chrisburtner/rotibot/test_data/0/description.txt

****************************************************************
none
jnpitt@uw.edu
jason
none
1496168130
0
none
1
/var/www/robot_data/260/
0
0
expID:260
440
14012
3
A3
****************************************************************
::br::
