chrisburtner/rotibot/documentation/software/11.pdf

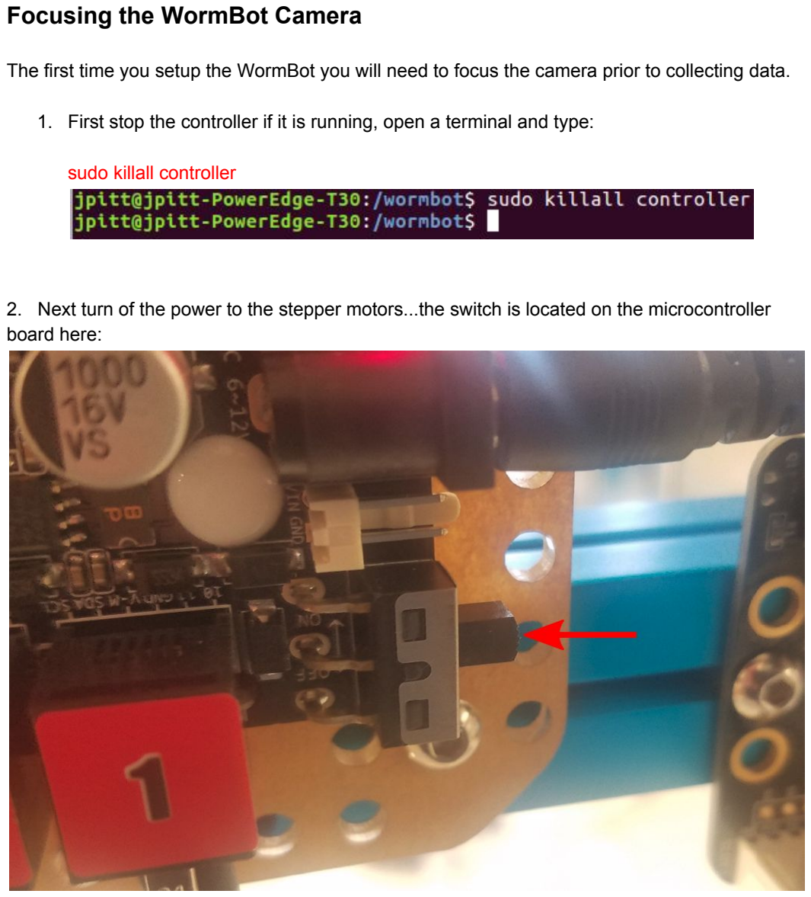
[picture p1: page 1]

### Focusing the WormBot Camera

The first time you setup the WormBot you will need to focus the camera prior to collecting data.

1. First stop the controller if it is running, open a terminal and type:

sudo killall controller

2. Next turn of the power to the stepper motors...the switch is located on the microcontroller board here:

3. Place a 12-well plate with some worms in a well on the robot and manually move the camera over the well. Note: This is discussed in other areas but the agar volume in the well should be 3mL. It is important to keep this volume fixed, although the camera has a decent depth of field and the worms will still be in focus even with some evaporation.

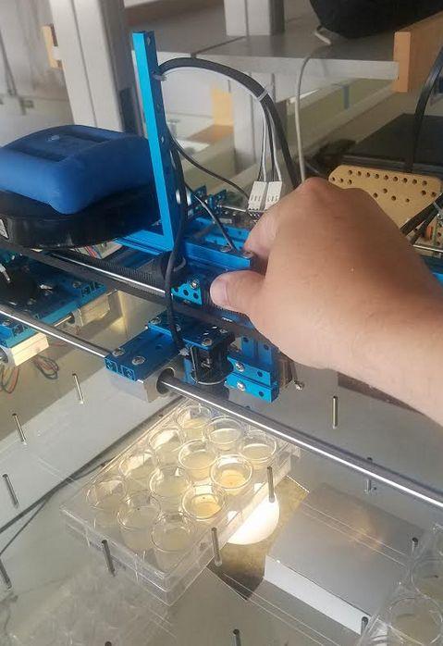
[picture p2: figure]
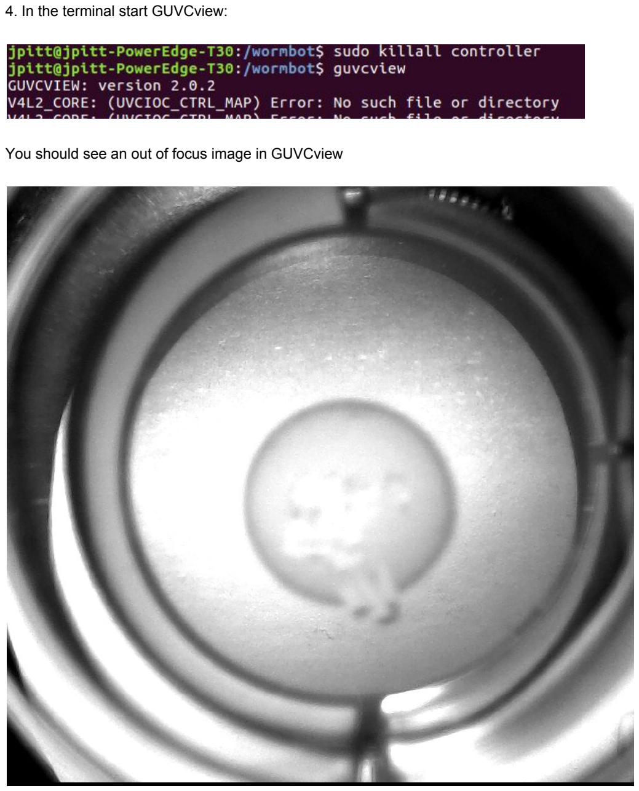
[picture p3: page 3]

4. In the terminal start GUVCview:

You should see an out of focus image in GUVCview

5. Center the camera head over the well and then rotate the camera lens to focus on the worms so that they are in sharp focus in the GUVCview window

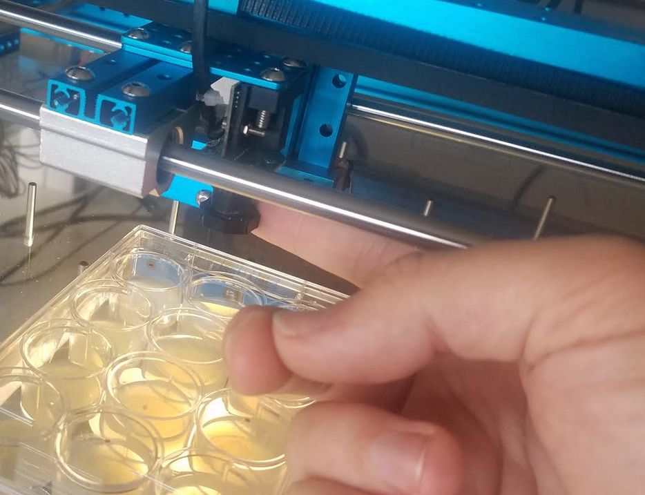
[picture p4: figure]

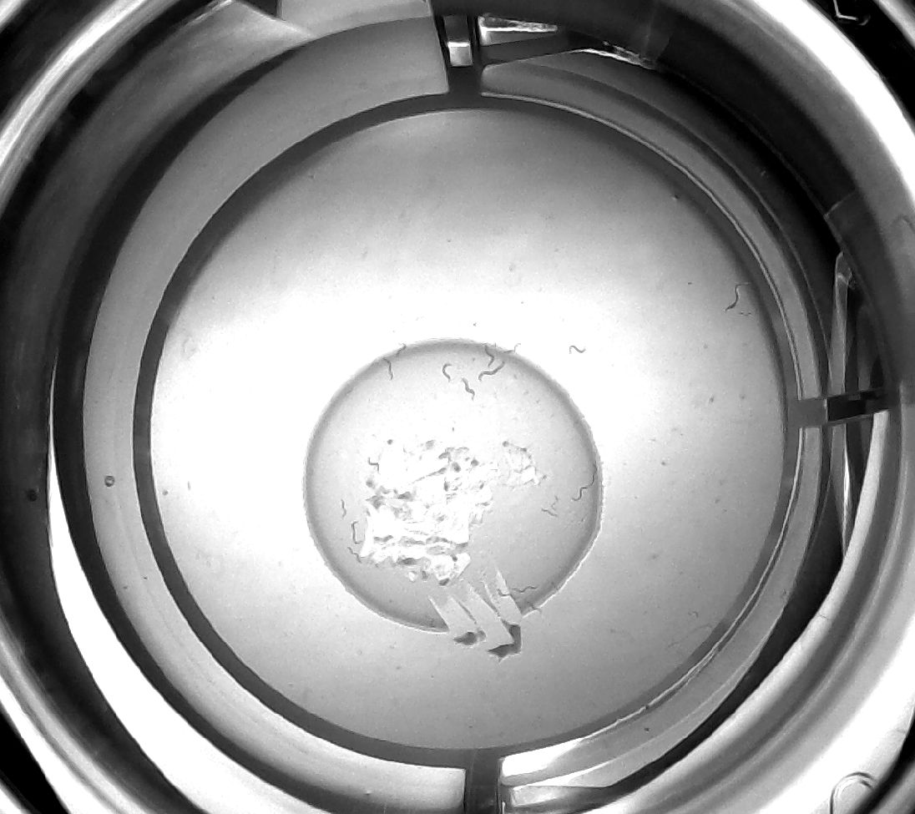
[picture p5: figure]

Note: this is also a good time to adjust your reflector angle to make sure you have optimal contrast and illumination. You can also adjust the brightness and contrast settings in
GUVCview until the image looks optimal and then update the values in /wormbot/camera.config

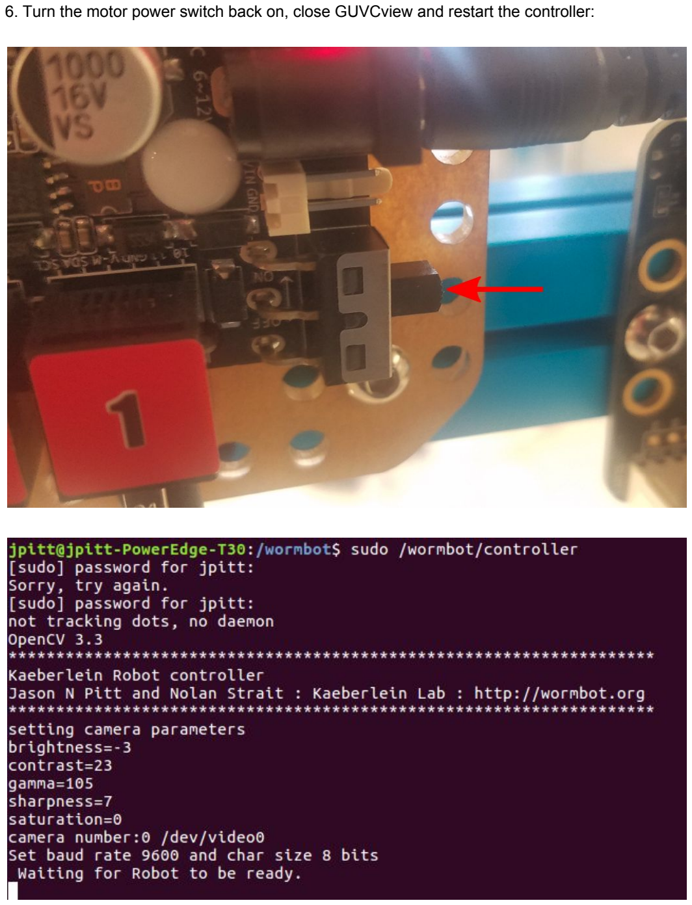
[picture p6: page 6]

6. Turn the motor power switch back on, close GUVCview and restart the controller:
