chrisburtner/rotibot/documentation/software/5.pdf

### Manually scoring a lifespan with the Marker application

The Marker application is an extremely lightweight cgi-app that allows you to score experiments in a web browser on any sort of device (tablet, smartphone, etc). However it is manual, so you will have to scroll through the movie and mark the death point of each worm. For a more automated approach we have a web app, Retrograde, that uses javascript and requires a three button mouse and will do much of the work for you. That said, some users still prefer the Marker application.

1. To open the Marker application, open a web browser on the server attached to the WormBot and go to: http://127.0.0.1/cgi-bin/experimentbrowser

Note: If you take sufficient security precautions you can assign you server a domain name and make it accessible from outside your local network, therby replacing the loop-back IP
(127.0.0.1) with your actual domain name or IP address
2. From the experiment browser scroll to the experiment of interest and click on the ExpID or on the title or description to open the Marker application.

Note: If you already know the experiment ID you can also manually enter the URL such as: http://127.0.0.1/cgi-bin/marker?loadedexpID=XXX where you would replace XXX with the experiment ID number

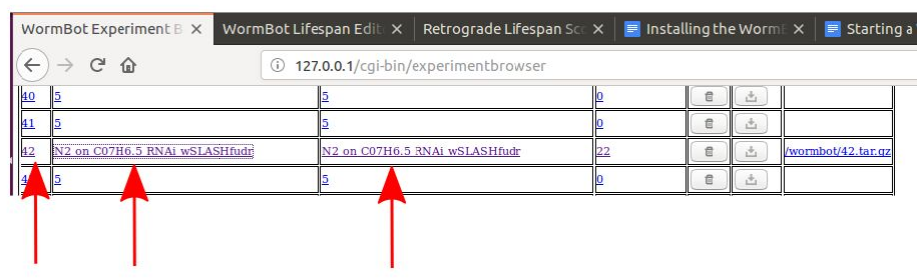
[picture p22: figure]

3. When you open the Marker application you will be presented with the following interface:

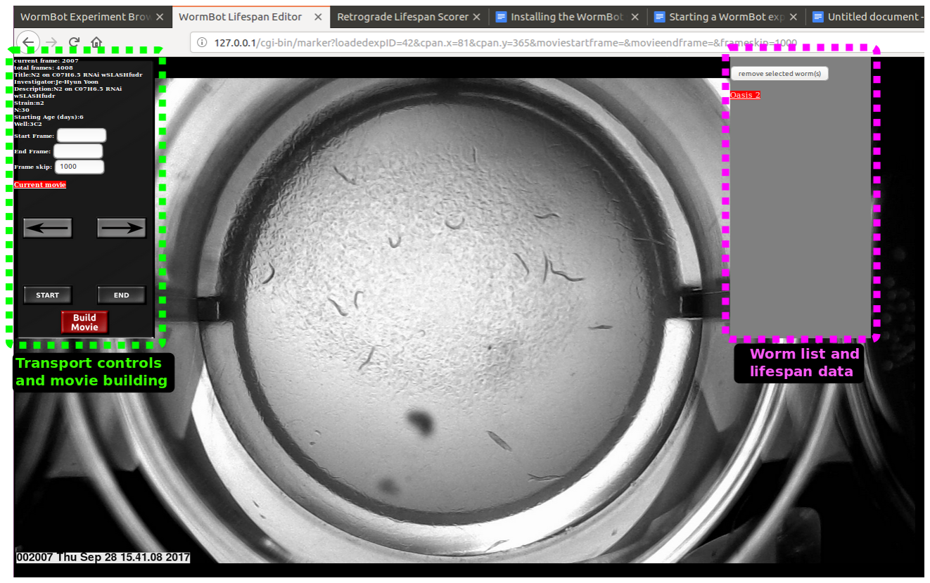
[picture p23: figure]

4. The left hand side (highlighted in green above) are the transport controls for scrolling through the experimental data. In the top portion of this control window are some details of the experiment, the currently displayed frame, the total number of frames, the title for the experiment and the description, the strain name, the starting age and well number. Below that are 3 input fields. The field labeled Frame skip, controls the number of frames the will be moved when you left click on either the left or right arrow buttons in the control window. Right is forward in time, left, backwards in time. The START and END buttons will transport you to the first and last frames of the data set respectively.

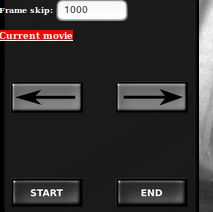
[picture p24: figure]

5. Manually scoring the data. Use the transport arrow buttons to move through the data set. When you observe a worm that ceases all body movement left click on the center of the worm. This will produce a numbered red circle on the worm and will add the worm to the wormlist window on the right side of the screen.

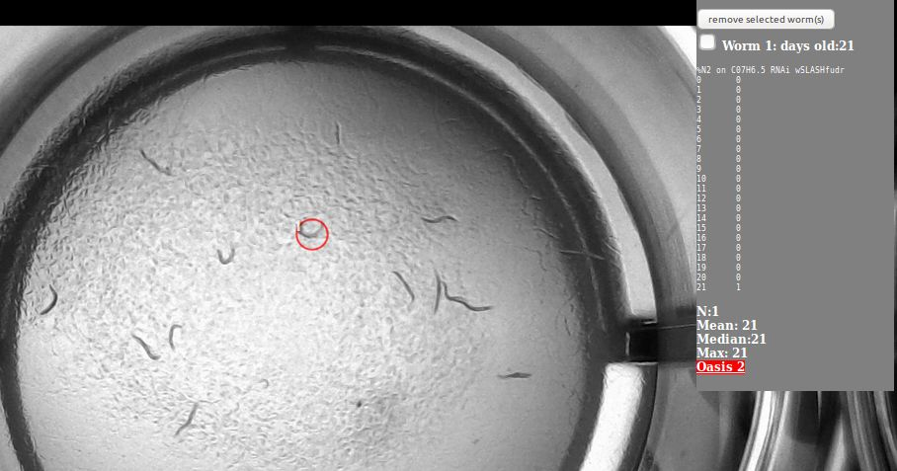
[picture p25: figure]

6. Continue processing the data until all worm death events have been marked. At this point the wormlist will have an observed N, mean, median and max lifespans. If you make a mistake or want to change the time/location of a worm’s death click in the checkbox next to the worm’s number in the wormlist window and click the remove selected worm button, then remark the death event at the desired timepoint.

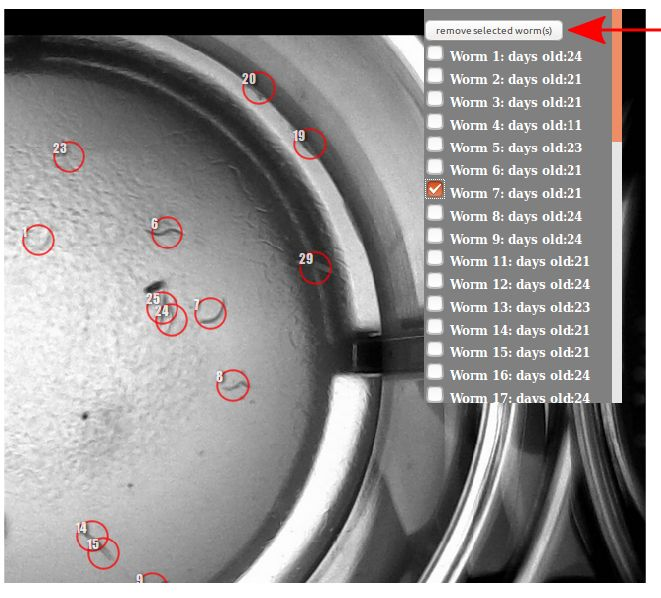
[picture p26: figure]

7. The bottom of the wormlist window contains the lifespan information in the format for the survival analysis web application OASIS 2 http://sbi.postech.ac.kr/oasis2/ You can copy the data from the wormlist window and click the OASIS 2 link in the bottom of the window and then use OASIS to analyze the data.

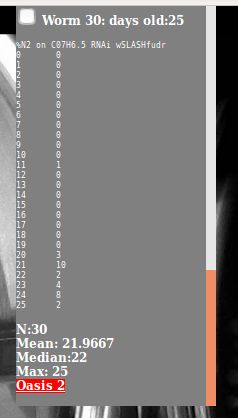
[picture p27: figure]

8. The other two fields in the left side Transport window, Start Frame and End Frame, control the Marker application’s movie making capability. To make a timelapse movie of the experiment, set the start frame and end frame fields to the desired start and end points and then left click on the red Build Movie button. Once the movie has been built you can download it by clicking on the Current Movie link. Note: for long movies this may take several minutes to complete. The movie will incorporate the marked death events in the final output.

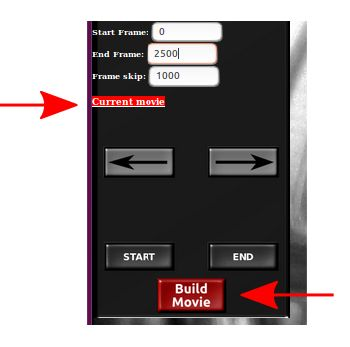
[picture p28: figure]
