chrisburtner/rotibot/documentation/software/8.pdf

### Manually starting the Controller and Alignerd applications

1. While the WormBot software has been observed to run problem free for months at a time occasionally things happen and the robot software may crash; either the aligner daemon (alignerd) or the WormBot controller itself. Symptoms that may indicate a crash are that the robot is no longer moving and collecting frames, indicating that controller has crashed or if aligned frames are no longer appearing indicating an alignerd crash.
2. To see if the software is running open a terminal window and type the command top (press the q key to exit top)

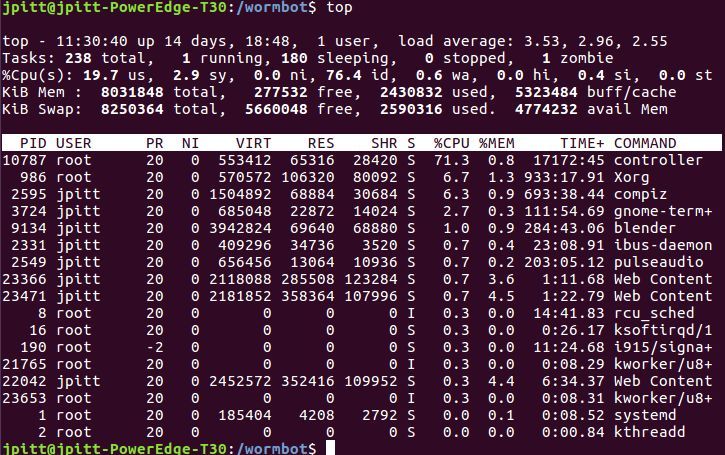
[picture p60: figure]

3. In the above example you can see that the top processes list does not contain the alignerd but does contain controller.

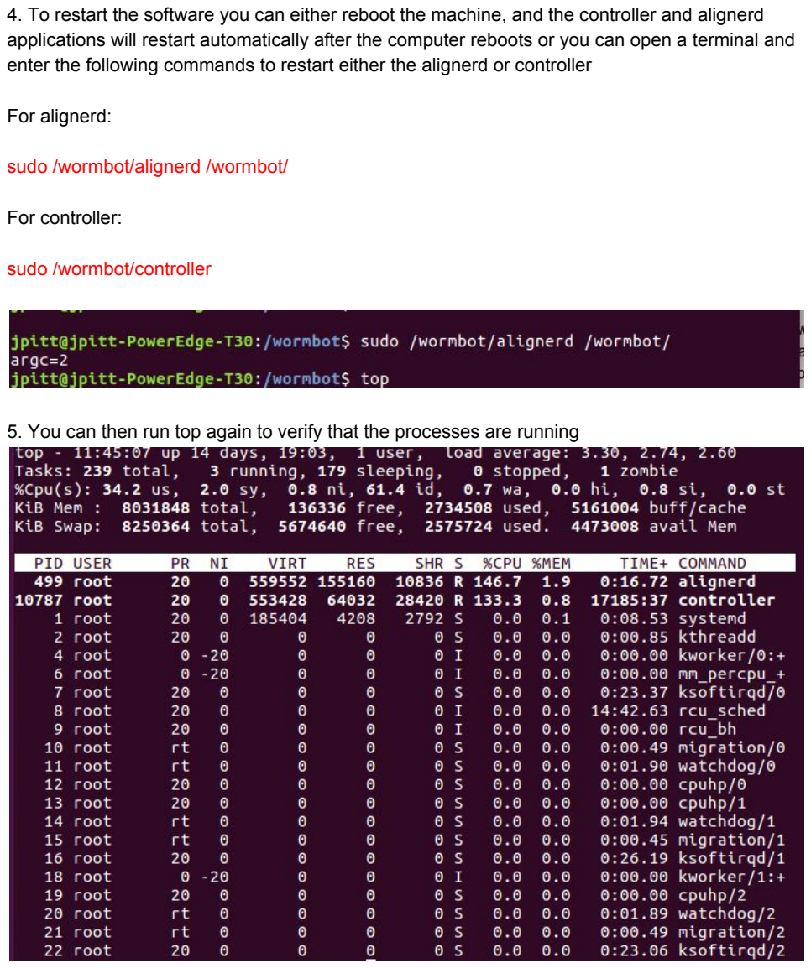
[picture p61: page 2]

4. To restart the software you can either reboot the machine, and the controller and alignerd applications will restart automatically after the computer reboots or you can open a terminal and enter the following commands to restart either the alignerd or controller

For alignerd:

sudo /wormbot/alignerd /wormbot/

For controller:

sudo /wormbot/controller

5. You can then run top again to verify that the processes are running
