chrisburtner/rotibot/stl_files/v3_standard/v3full_estop.stl

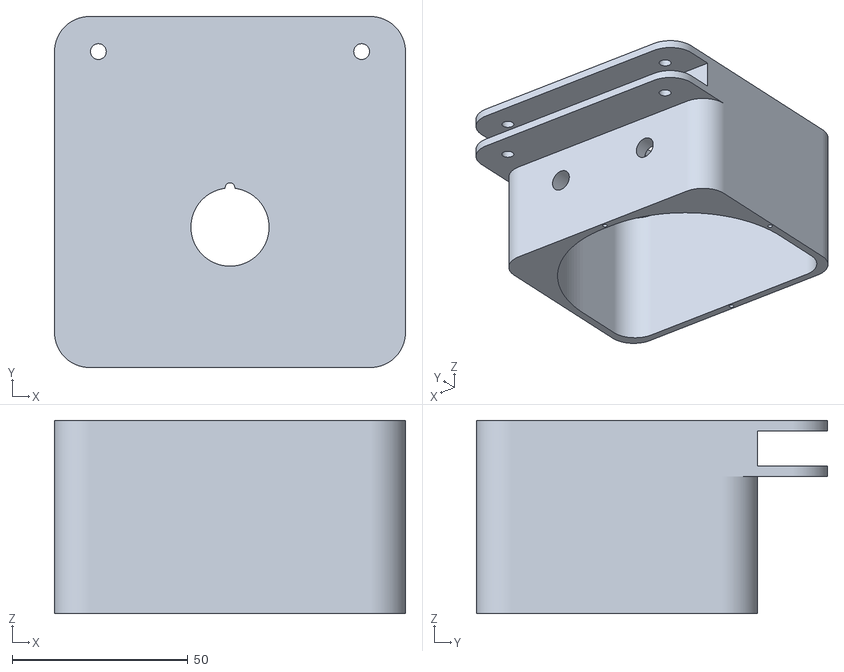
[picture p62: CAD file, 2022-04-04]
stl_files/v3_standard/v3full_estop.stl
100.0 x 100.0 x 55.0
