chrisburtner/rotibot/stl_files/common_parts/commonPartsPrintSet_3.stl

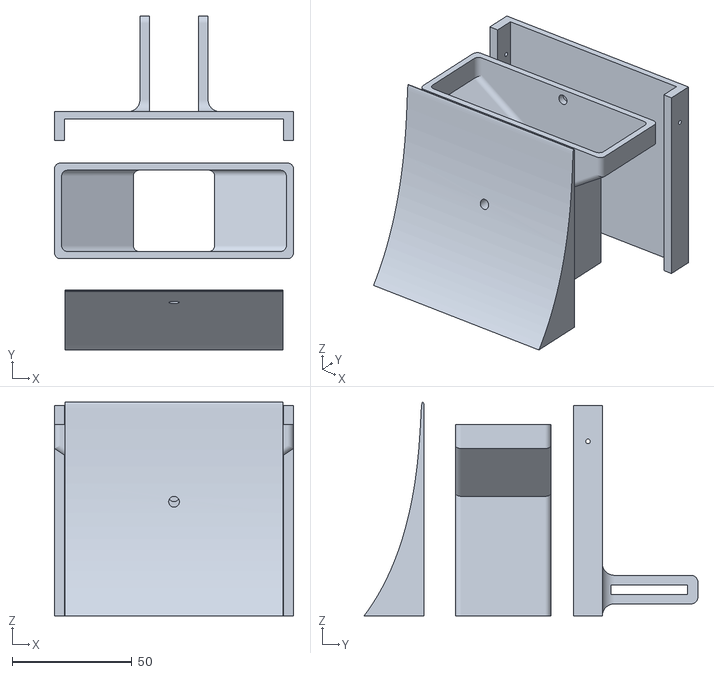
[picture p63: CAD file, 2022-10-11]
stl_files/common_parts/commonPartsPrintSet_3.stl
100.0 x 139.7 x 89.4
