chrisburtner/rotibot/stl_files/darkfield/highbase.stl

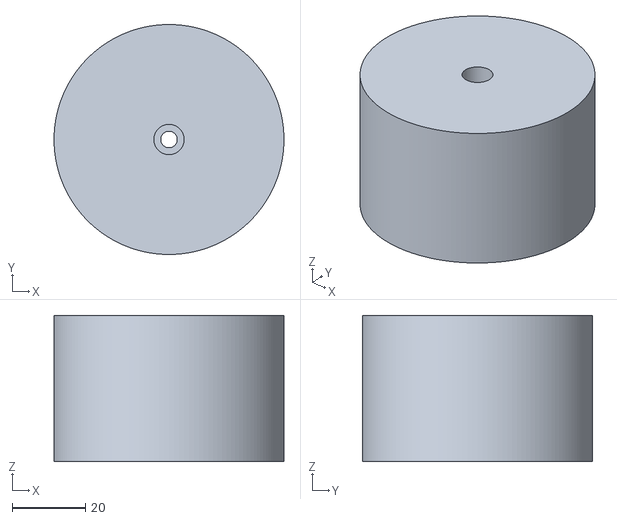
[picture p64: CAD file, 2022-02-23]
stl_files/darkfield/highbase.stl
62.8 x 62.8 x 40.0
