chrisburtner/rotibot/stl_files/v3_mini/miniPartsPrintSet.stl

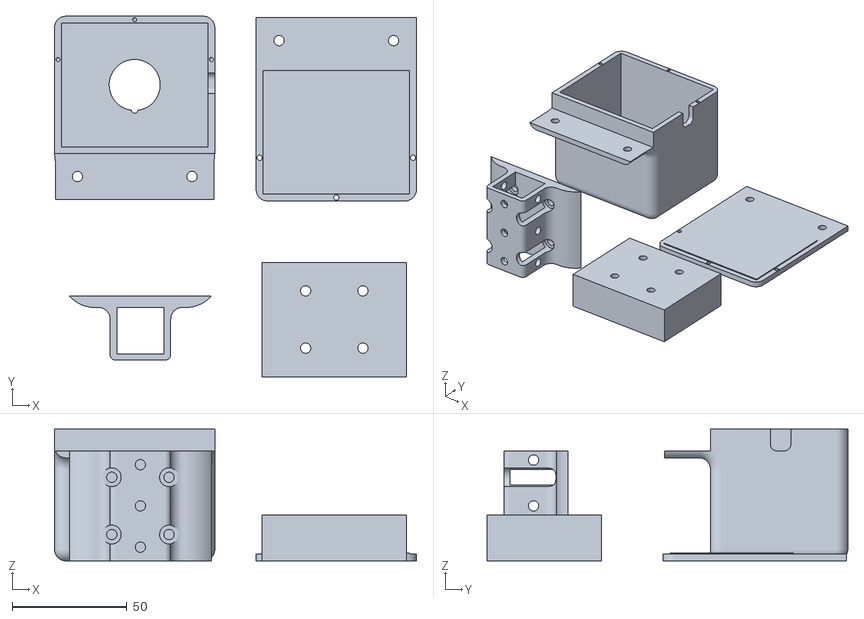
[picture p65: CAD file, 2022-10-10]
stl_files/v3_mini/miniPartsPrintSet.stl
158.0 x 157.4 x 57.5
