chrisburtner/rotibot/stl_files/v3_standard/standardPrintSet.stl

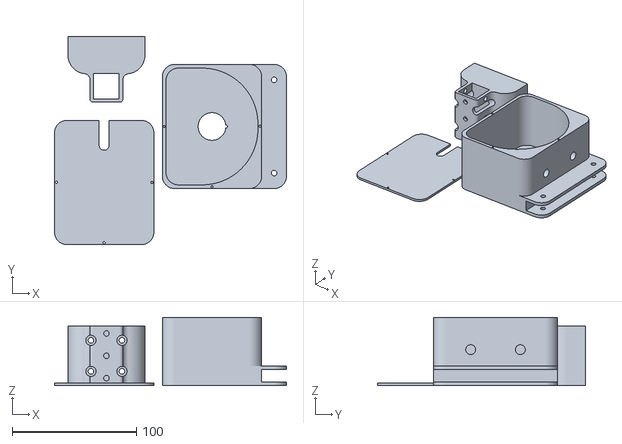
[picture p66: CAD file, 2022-10-10]
stl_files/v3_standard/standardPrintSet.stl
186.8 x 167.6 x 55.0
