chrisburtner/rotibot/stl_files/v3F/fluorescencePrintSet.stl

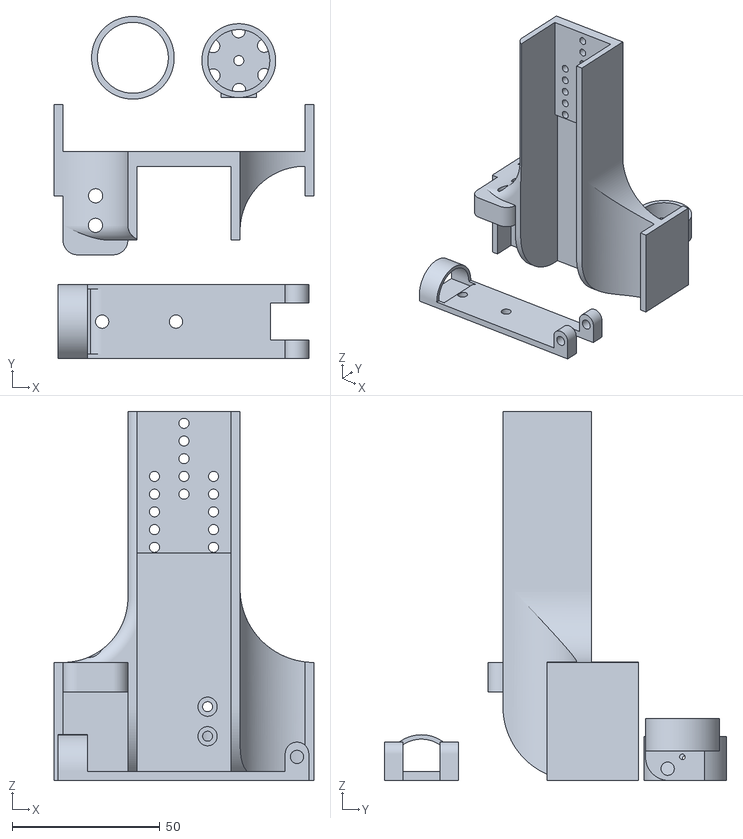
[picture p67: CAD file, 2022-10-07]
stl_files/v3F/fluorescencePrintSet.stl
88.0 x 115.9 x 125.0
