chrisburtner/rotibot/stl_files/common_parts/v3-reflector-tube.stl

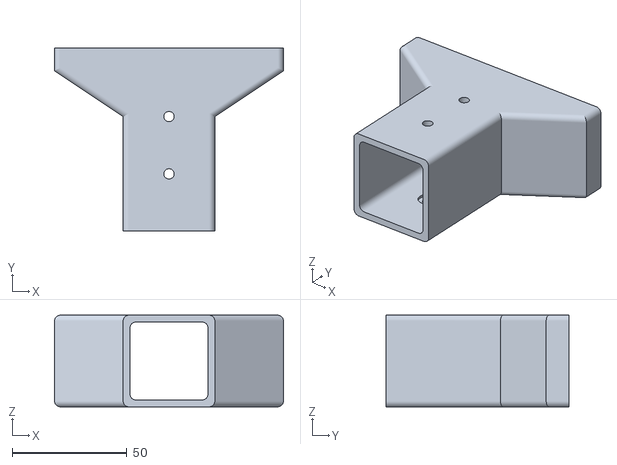
[picture p68: CAD file, 2022-02-23]
stl_files/common_parts/v3-reflector-tube.stl
100.0 x 80.0 x 40.0
