chrisburtner/rotibot/stl_files/darkfield/mokoseholder.stl

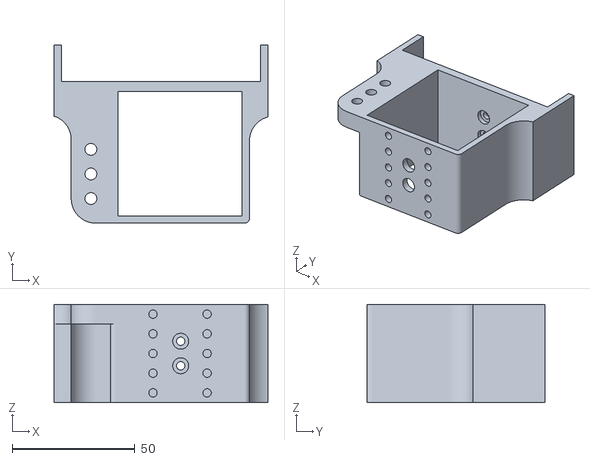
[picture p69: CAD file, 2022-02-23]
stl_files/darkfield/mokoseholder.stl
87.0 x 72.5 x 40.0
