chrisburtner/rotibot/stl_files/v3_mini/miniEStopCover.stl

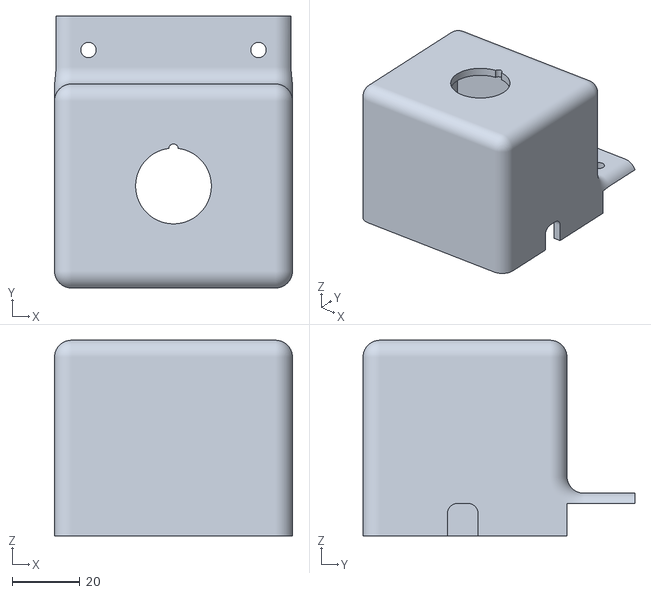
[picture p70: CAD file, 2022-04-04]
stl_files/v3_mini/miniEStopCover.stl
70.0 x 80.0 x 57.5
