chrisburtner/rotibot/stl_files/v3F/starholder_V2.stl

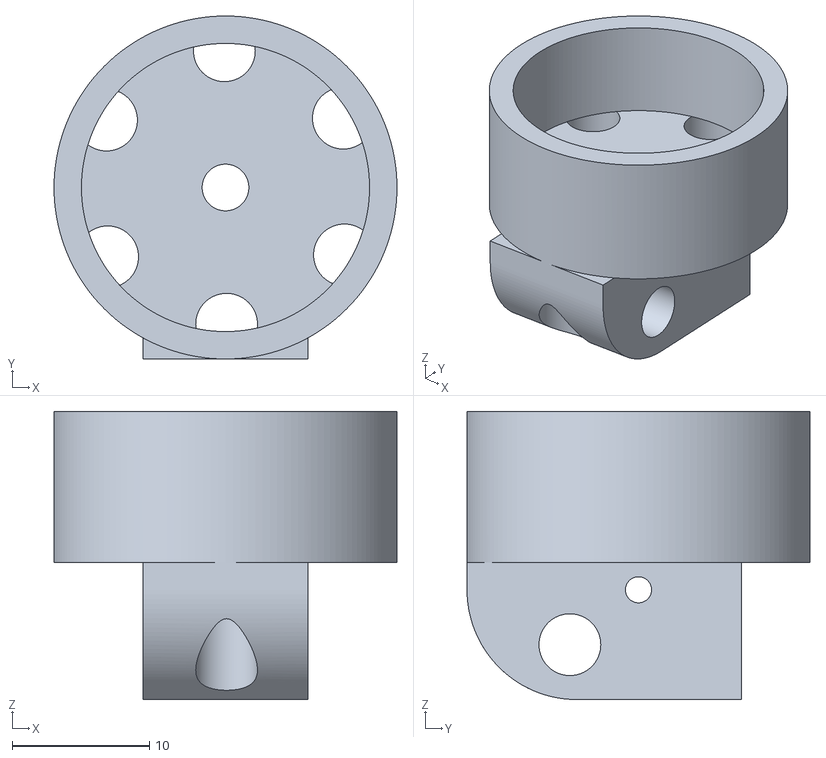
[picture p71: CAD file, 2022-02-23]
stl_files/v3F/starholder_V2.stl
25.0 x 25.0 x 21.0
