chrisburtner/rotibot/stl_files/common_parts/precisionLimitHolder.stl

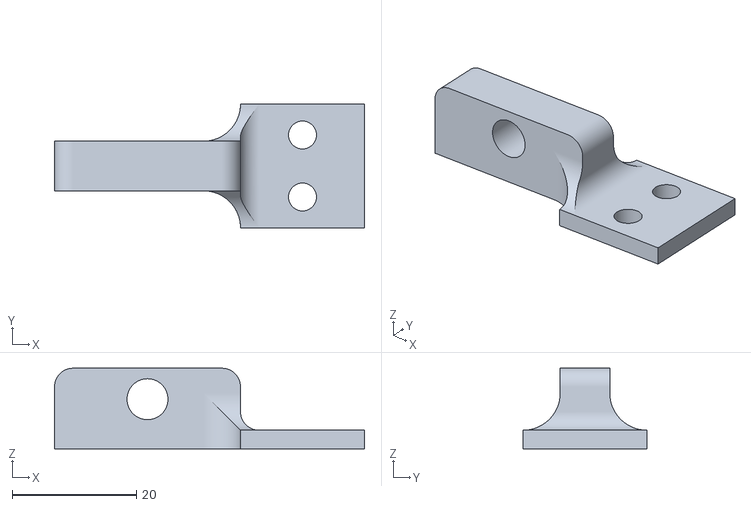
[picture p72: CAD file, 2022-02-23]
stl_files/common_parts/precisionLimitHolder.stl
50.0 x 20.0 x 13.0
