chrisburtner/rotibot/stl_files/darkfield/longplug.stl

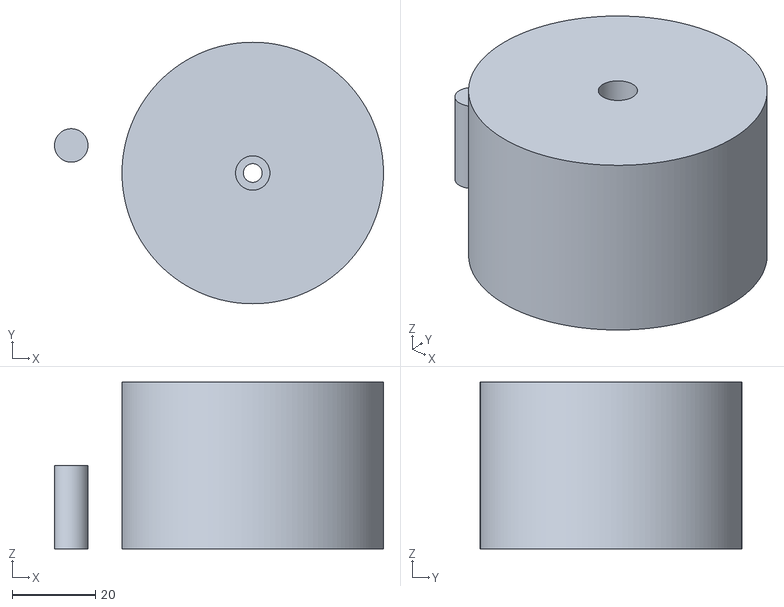
[picture p73: CAD file, 2022-02-23]
stl_files/darkfield/longplug.stl
79.0 x 62.8 x 40.0
