chrisburtner/rotibot/stl_files/v3_mini/miniEStopBase.stl

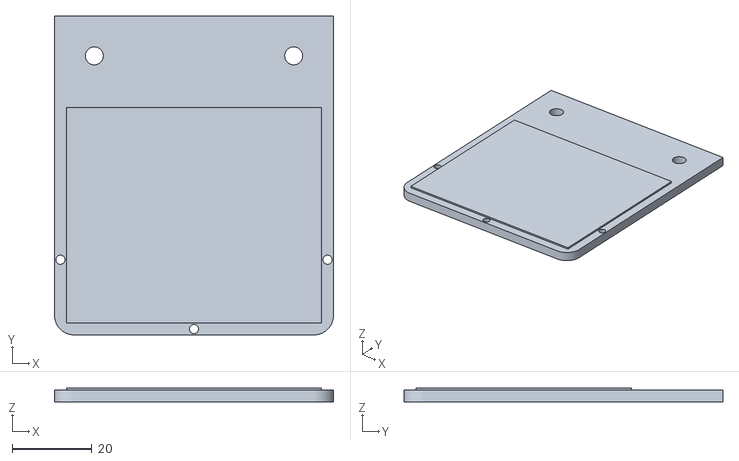
[picture p74: CAD file, 2022-02-23]
stl_files/v3_mini/miniEStopBase.stl
70.0 x 80.0 x 3.52
