chrisburtner/rotibot/stl_files/v3_standard/v3-estopbase-w-holes.stl

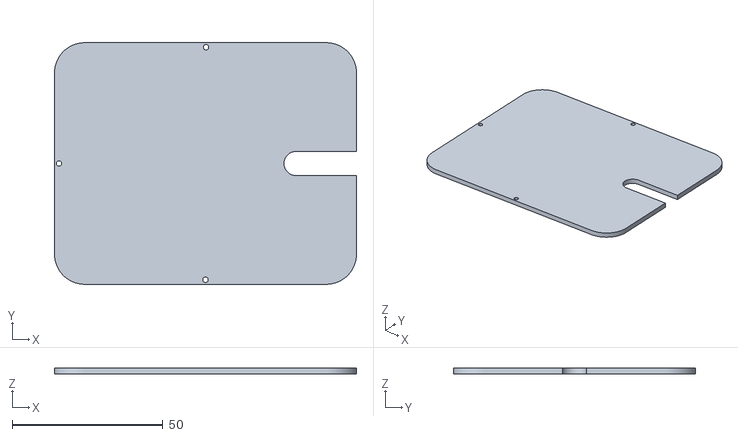
[picture p75: CAD file, 2022-02-23]
stl_files/v3_standard/v3-estopbase-w-holes.stl
100.0 x 80.0 x 2.00
