chrisburtner/rotibot/stl_files/v3F/xfiltercover.stl

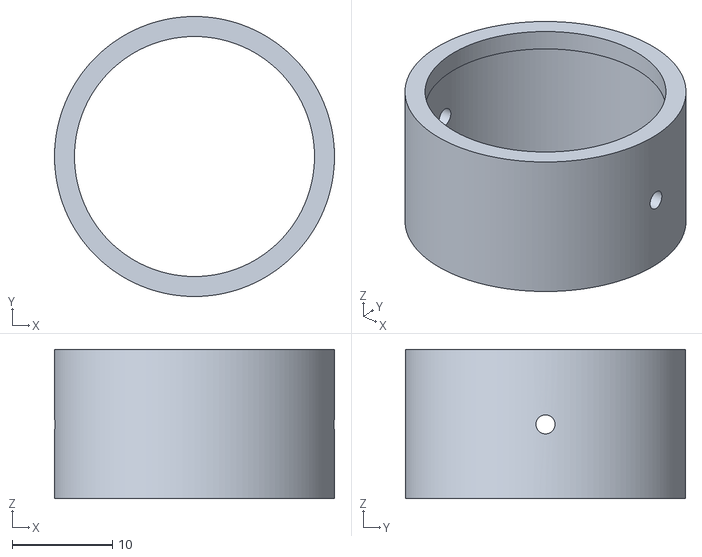
[picture p76: CAD file, 2022-02-23]
stl_files/v3F/xfiltercover.stl
28.0 x 28.0 x 14.9
