chrisburtner/rotibot/stl_files/common_parts/5wattLEDholder.stl

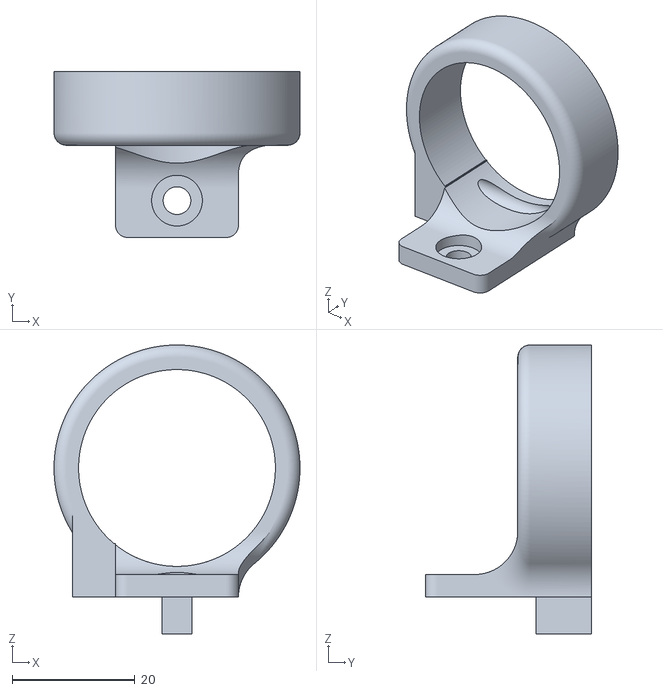
[picture p77: CAD file, 2022-02-23]
stl_files/common_parts/5wattLEDholder.stl
40.0 x 27.0 x 47.0
