chrisburtner/rotibot/stl_files/v3_mini/camera20mmspacer.stl

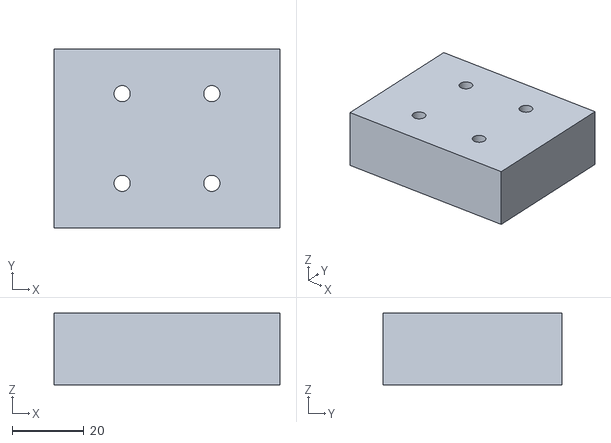
[picture p78: CAD file, 2022-02-23]
stl_files/v3_mini/camera20mmspacer.stl
63.0 x 50.0 x 20.0
