chrisburtner/rotibot/stl_files/v3_standard/v3reflectorbase.stl

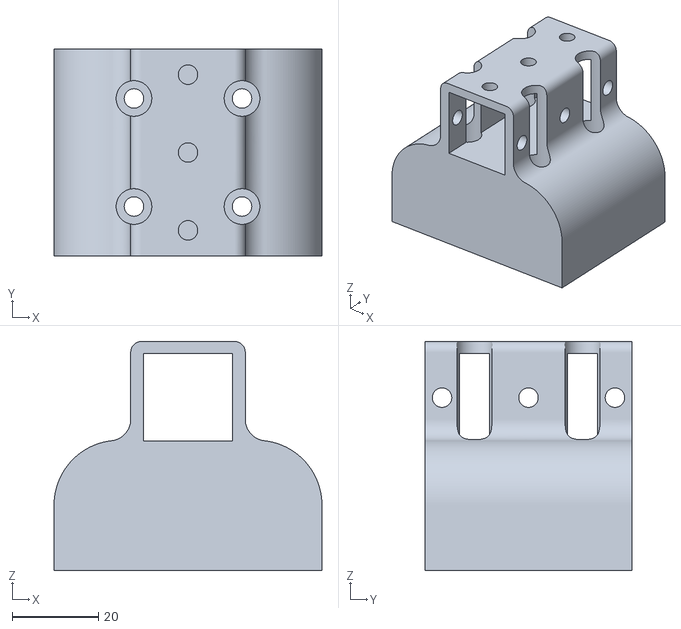
[picture p79: CAD file, 2022-02-23]
stl_files/v3_standard/v3reflectorbase.stl
62.0 x 48.0 x 53.0
