chrisburtner/rotibot/stl_files/v3F/baslerUeyeCameraHolder.stl

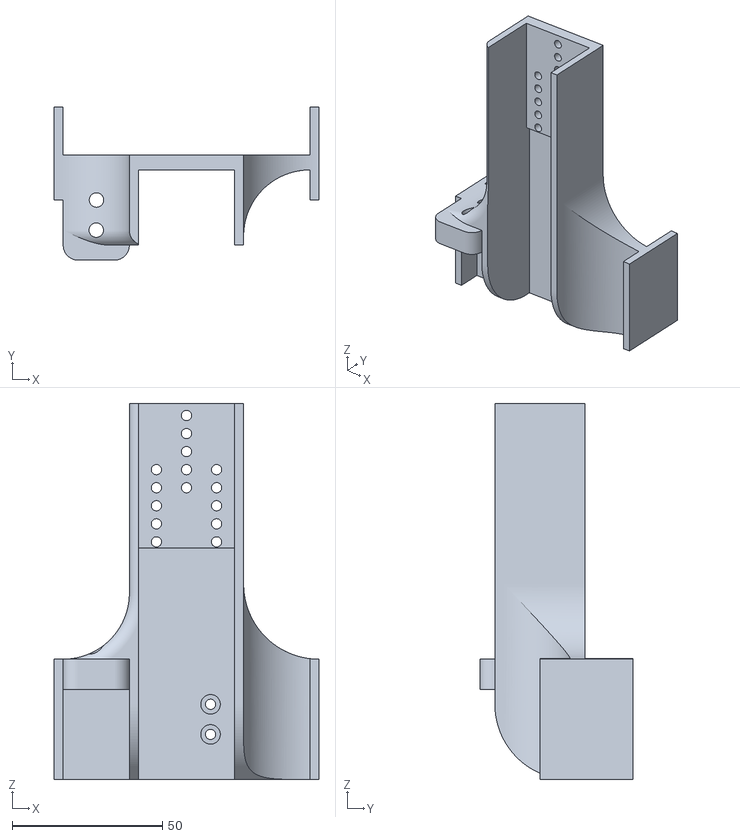
[picture p80: CAD file, 2022-02-23]
stl_files/v3F/baslerUeyeCameraHolder.stl
88.0 x 51.0 x 125.0
