chrisburtner/rotibot/stl_files/common_parts/largeDragBracket.stl

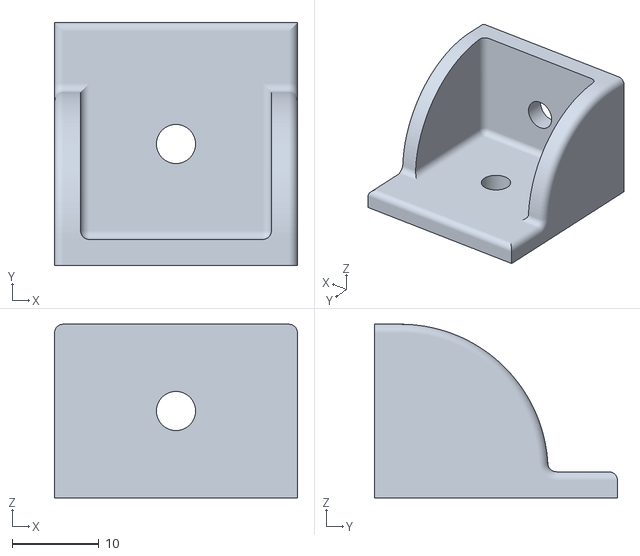
[picture p81: CAD file, 2022-02-23]
stl_files/common_parts/largeDragBracket.stl
28.0 x 28.0 x 20.0
