chrisburtner/rotibot/stl_files/v3_mini/mini-reflector-base.stl

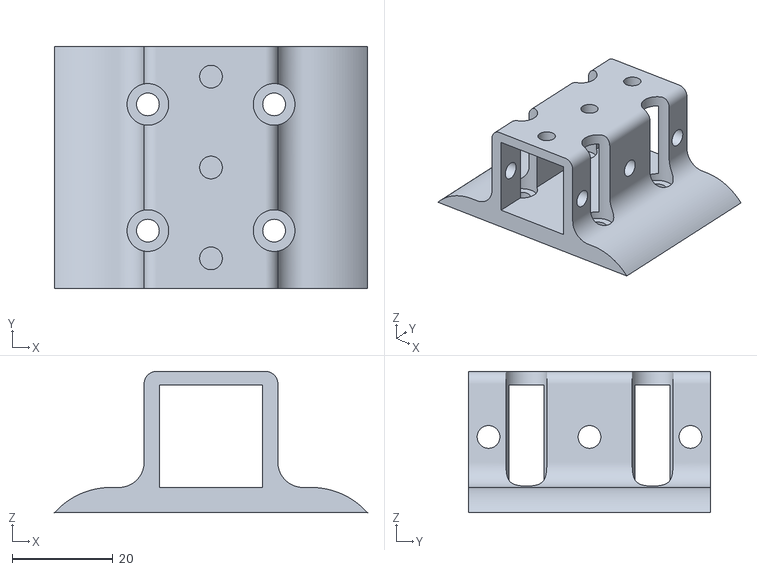
[picture p82: CAD file, 2022-02-23]
stl_files/v3_mini/mini-reflector-base.stl
62.0 x 48.0 x 28.0
