chrisburtner/rotibot/stl_files/v3F/fluorbase_v2.stl

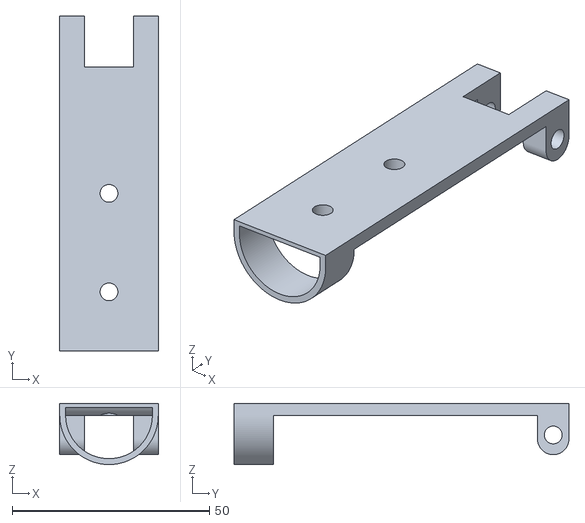
[picture p83: CAD file, 2022-02-23]
stl_files/v3F/fluorbase_v2.stl
25.0 x 85.0 x 15.5
