chrisburtner/rotibot/stl_files/common_parts/rightLinearBracket.stl

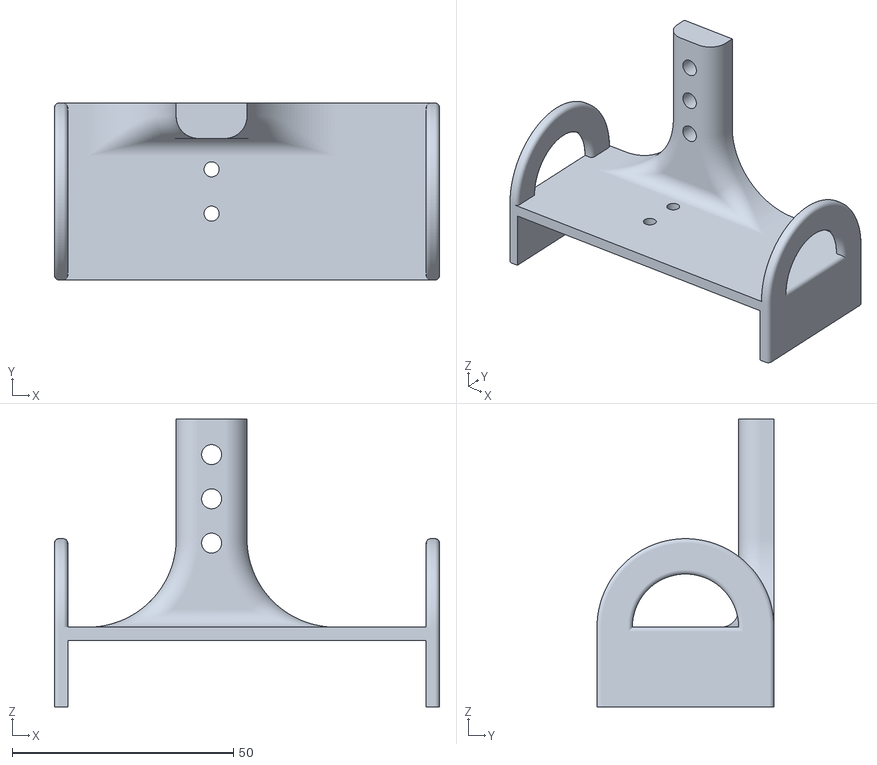
[picture p84: CAD file, 2022-02-23]
stl_files/common_parts/rightLinearBracket.stl
87.0 x 40.0 x 65.0
