chrisburtner/rotibot/stl_files/common_parts/parabolicReflector.stl

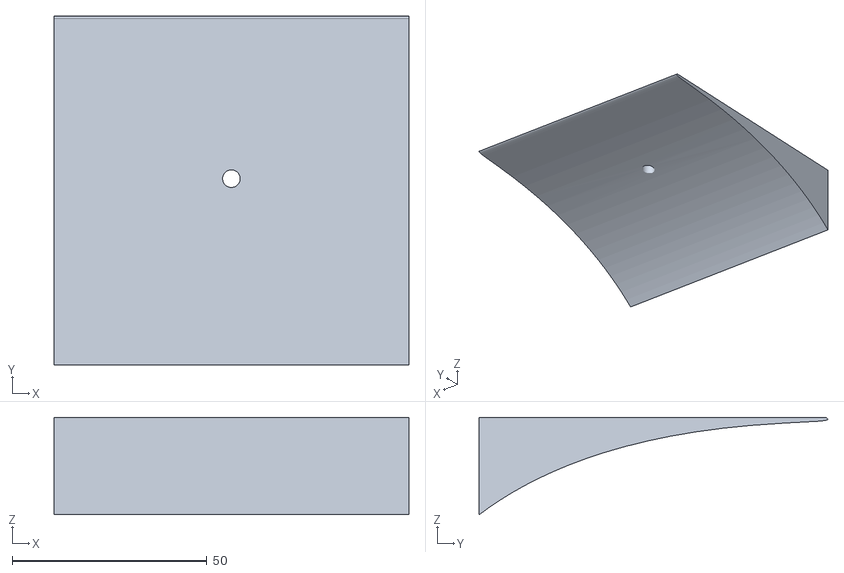
[picture p85: CAD file, 2022-02-23]
stl_files/common_parts/parabolicReflector.stl
91.1 x 89.4 x 25.0
