chrisburtner/rotibot/stl_files/common_parts/lowMagCameraHolder.stl

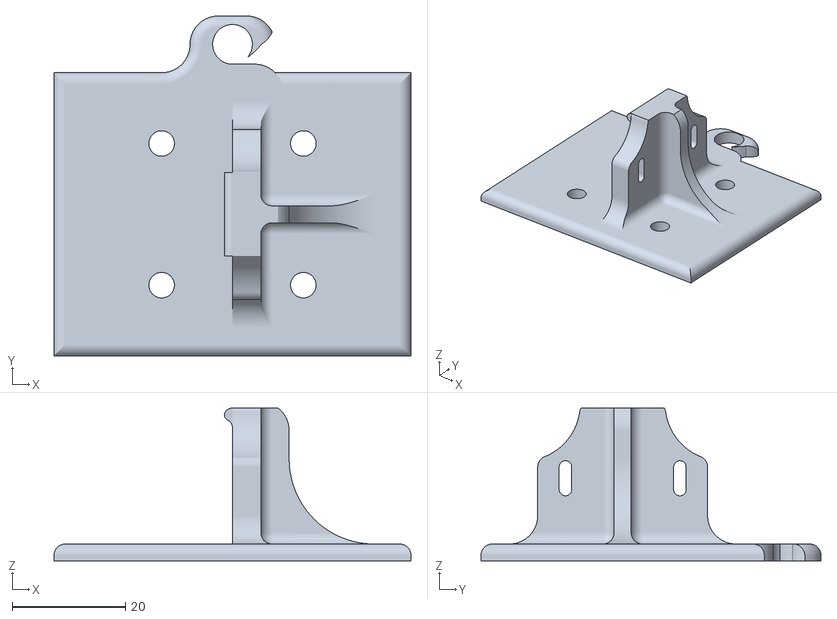
[picture p86: CAD file, 2022-02-23]
stl_files/common_parts/lowMagCameraHolder.stl
63.0 x 60.0 x 27.0
