chrisburtner/rotibot/stl_files/common_parts/curveWireClip.stl

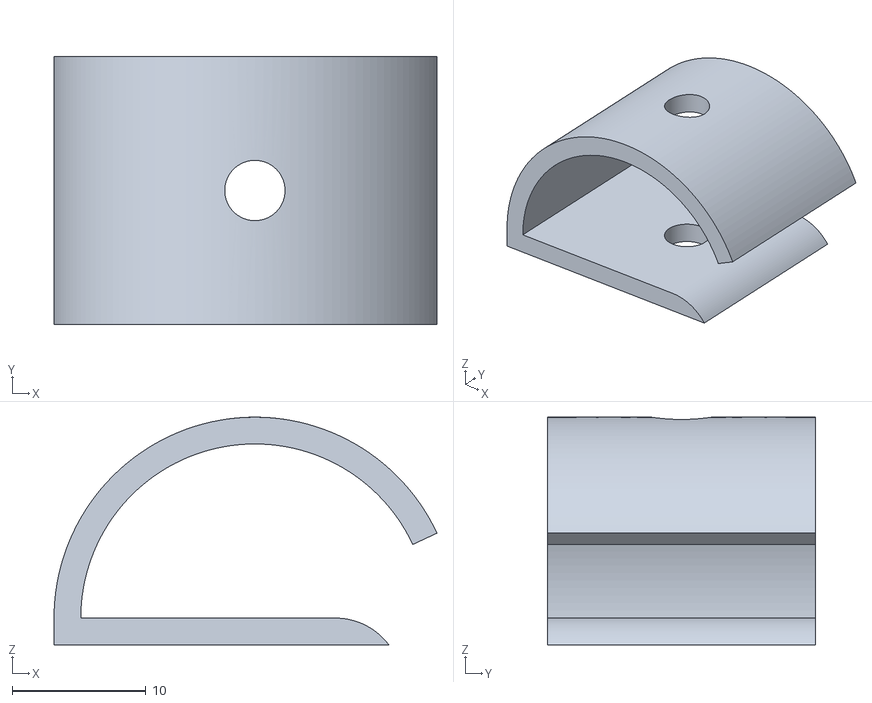
[picture p87: CAD file, 2022-02-23]
stl_files/common_parts/curveWireClip.stl
28.6 x 20.0 x 17.0
