chrisburtner/rotibot/stl_files/common_parts/v3-reflector-tray.stl

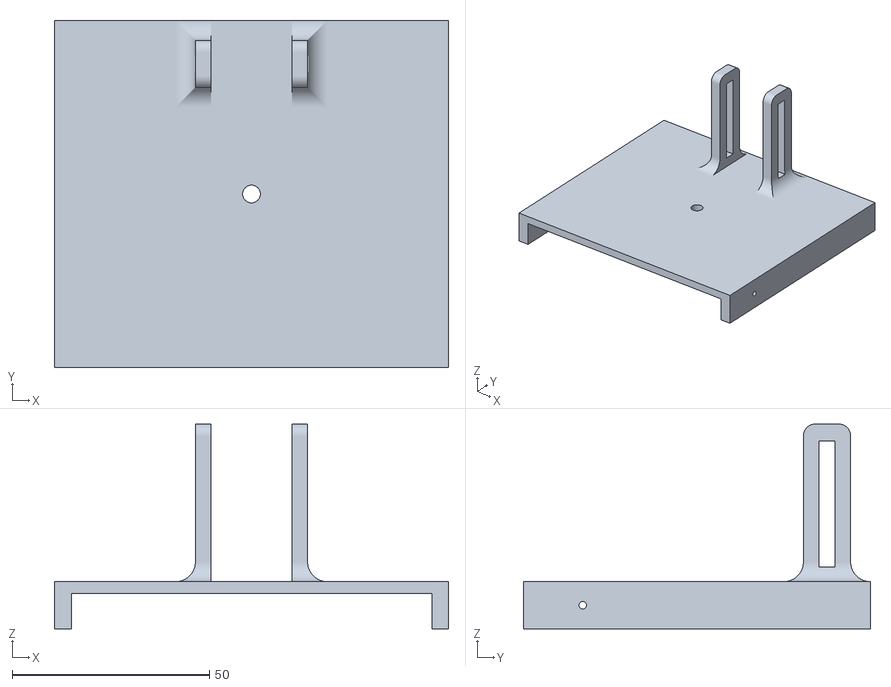
[picture p88: CAD file, 2022-02-23]
stl_files/common_parts/v3-reflector-tray.stl
100.0 x 88.0 x 52.0
