chrisburtner/rotibot/stl_files/common_parts/standardLimitSwitchHolder.stl

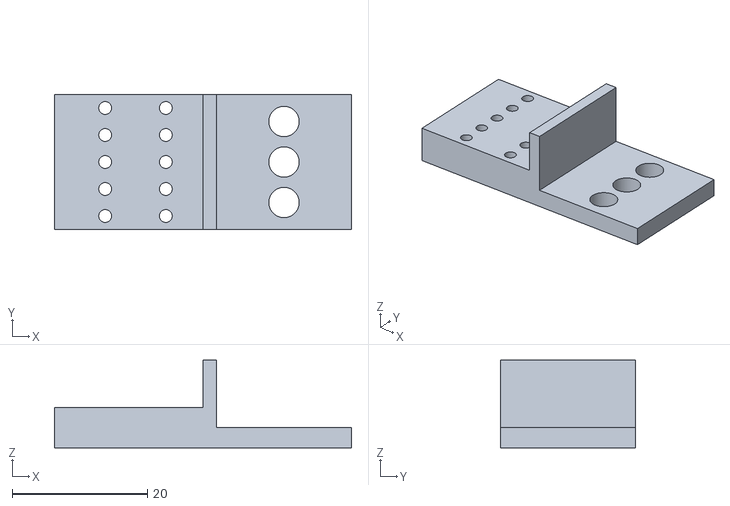
[picture p89: CAD file, 2022-02-23]
stl_files/common_parts/standardLimitSwitchHolder.stl
44.0 x 20.0 x 13.0
