chrisburtner/rotibot/stl_files/common_parts/arduino-20mmbracket.stl

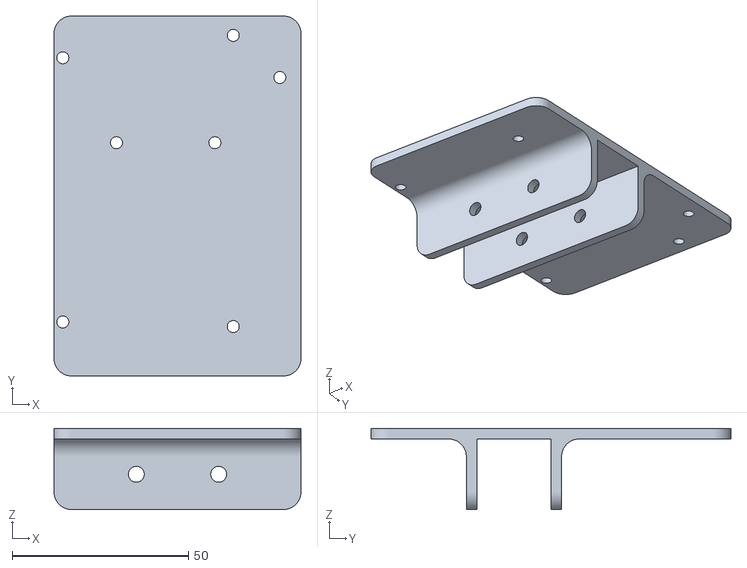
[picture p90: CAD file, 2022-02-23]
stl_files/common_parts/arduino-20mmbracket.stl
70.0 x 102.0 x 23.0
