chrisburtner/rotibot/stl_files/common_parts/widewireclamp.stl

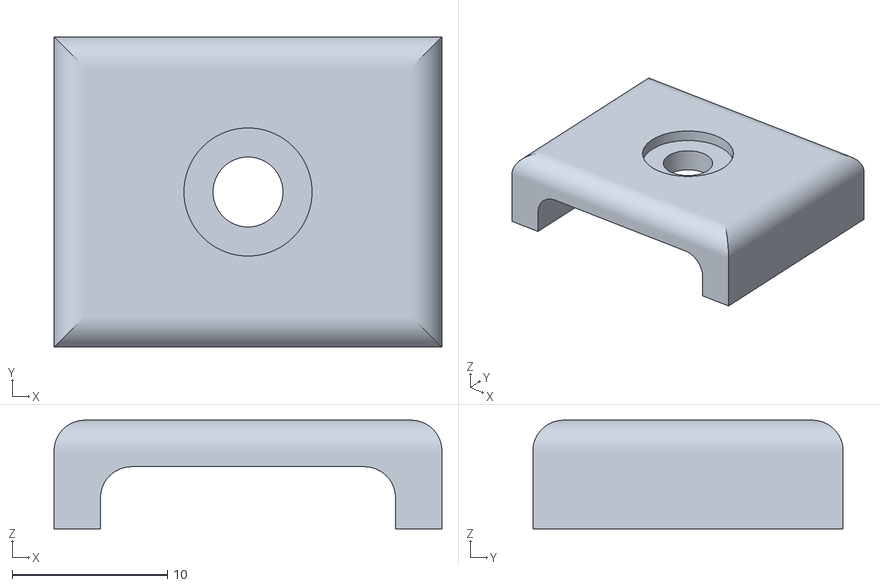
[picture p91: CAD file, 2022-02-23]
stl_files/common_parts/widewireclamp.stl
25.0 x 20.0 x 7.00
