chrisburtner/rotibot/stl_files/common_parts/powerbrickholder.stl.stl

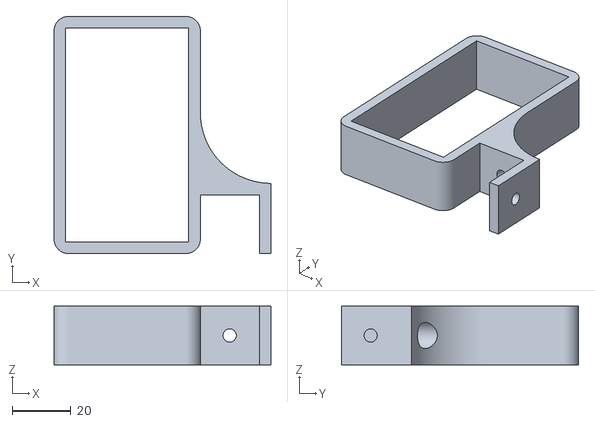
[picture p92: CAD file, 2022-02-23]
stl_files/common_parts/powerbrickholder.stl.stl
74.1 x 81.0 x 20.0
