chrisburtner/rotibot/(list of files, cad)

Other CAD files:
stl_files/common_parts/leftLinearBracket.stl
