chrisburtner/rotibot/eagleFiles/4channelWormbotShield_fixed_PCBv03_addSSRresist_wThermalRel.brd

## EAGLE design eagleFiles/4channelWormbotShield_fixed_PCBv03_addSSRresist_wThermalRel.brd (2022-02-03)

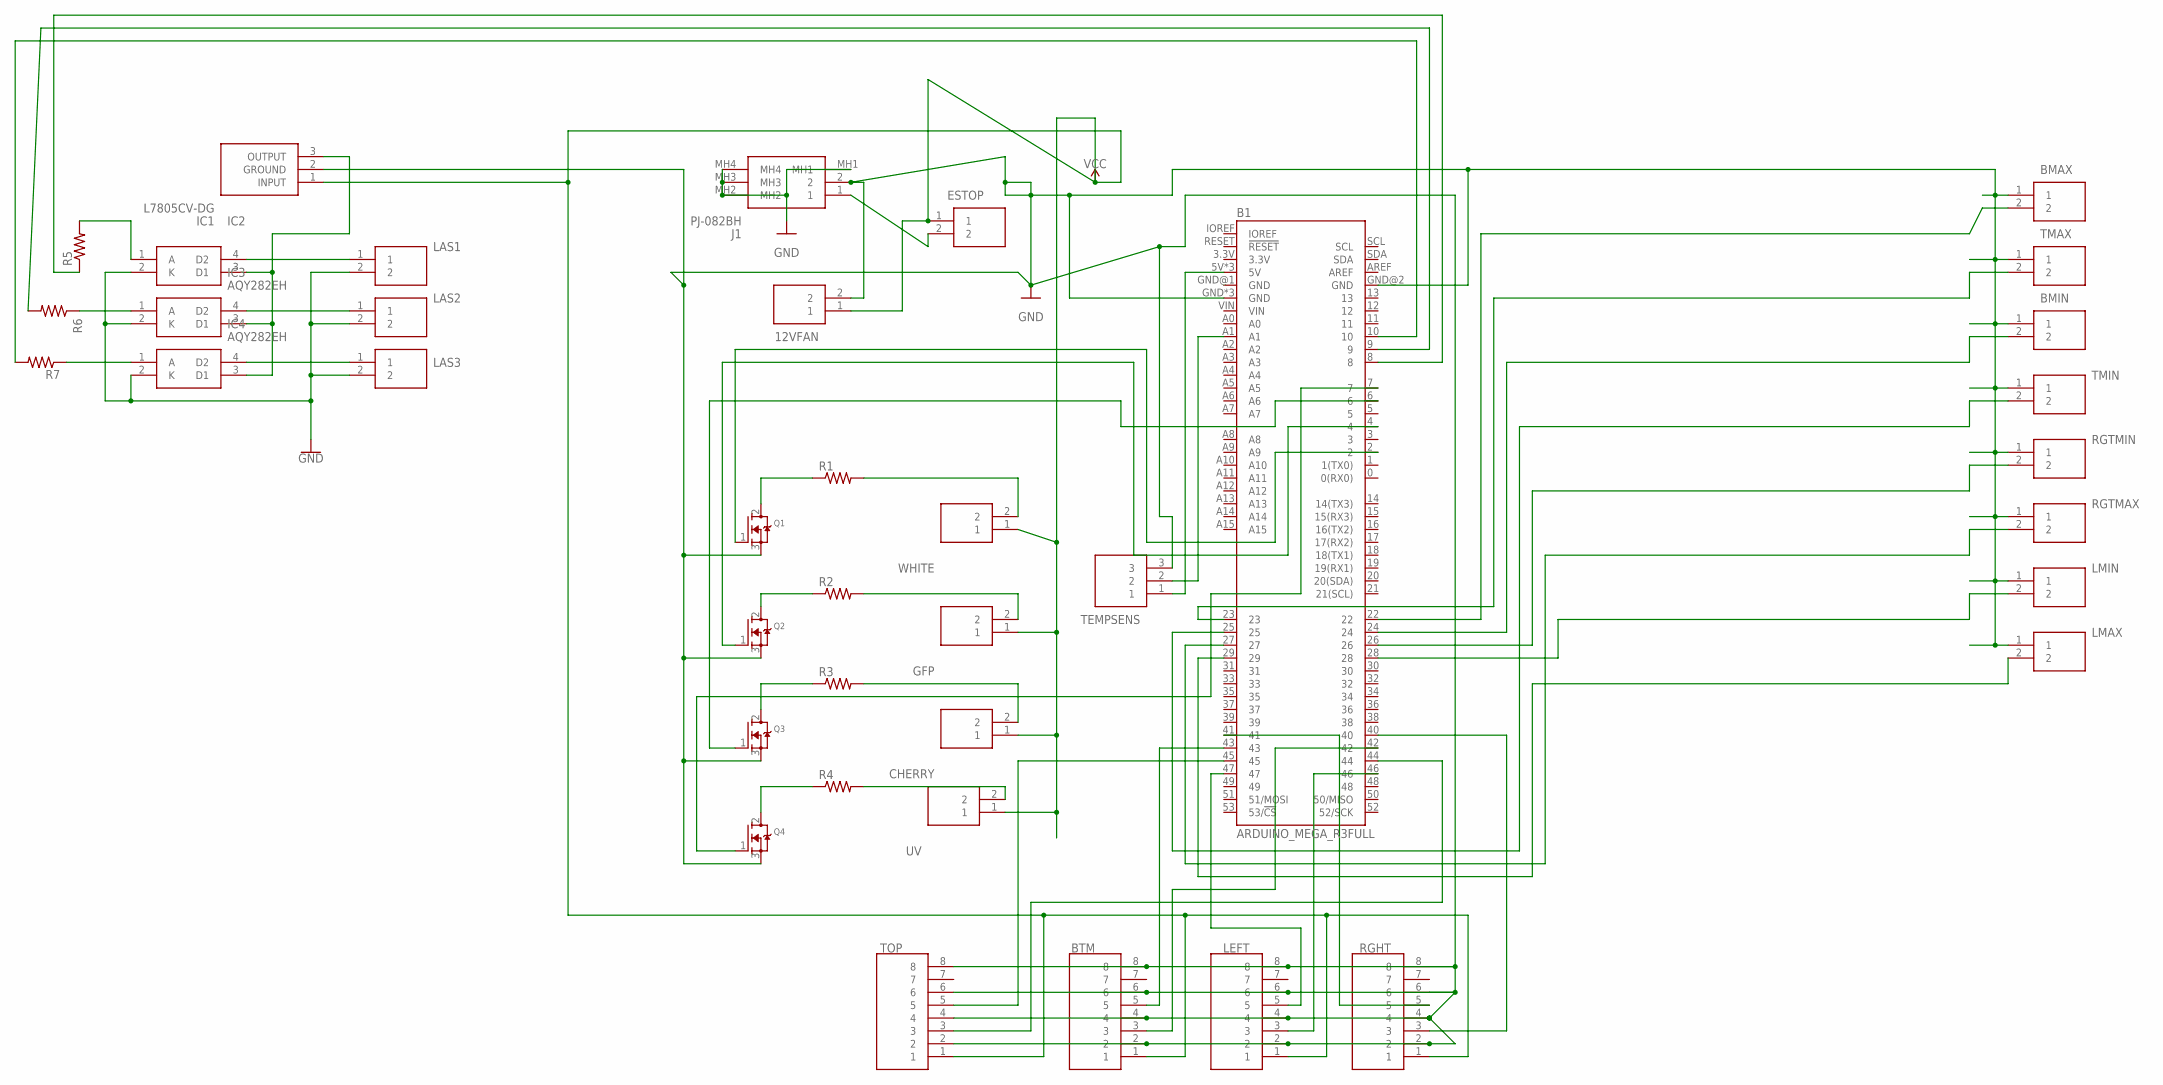
[picture p93: schematic 4channelWormbotShield_fixed_PCBv03_addSSRresist_wThermalRel.sch]

Parts:
12VFAN: 1725656
B1: ARDUINO_MEGA_R3FULL; ARDUINO_MEGA_NO_SILK
BMAX: 1725656
BMIN: 1725656
BTM: 1725711
CHERRY: 1725656
ESTOP: TB003-500-P02BE; SHDR2W100P0X500_1X2_1000X780X1
GFP: 1725656
IC1: L7805CV-DG; TO255P460X1020X2008-3P
IC2, IC3, IC4: AQY282EH; DIP762W57P254L478H340Q4N
J1: PJ-082BH; PJ082BH
LAS1, LAS2, LAS3: 1725656
LEFT: 1725711
LMAX: 1725656
LMIN: 1725656
Q1, Q2, Q3, Q4: MOSFET-NGDS_TO220V; TO220V
R1, R2, R3, R4, R5, R6, R7: R-US_0207/10; 0207/10
RGHT: 1725711
RGTMAX: 1725656
RGTMIN: 1725656
TEMPSENS: 1725669
TMAX: 1725656
TMIN: 1725656
TOP: 1725711
UV: 1725656
WHITE: 1725656

Connections:
GND: 12VFAN.2, B1.GND, B1.GND@2 (GND), B1.GND@3 (GND), B1.GND@4 (GND), BMAX.1, BMIN.1, BTM.2, BTM.4, BTM.6, BTM.8, IC1.2 (GROUND), IC2.2 (K), IC3.2 (K), IC4.2 (K), J1.2, J1.MH1, J1.MH2, J1.MH3, J1.MH4, LAS1.2, LAS2.2, LAS3.2, LEFT.2, LEFT.4, LEFT.6, LEFT.8, LMAX.1, LMIN.1, Q1.3 (S), Q2.3 (S), Q3.3 (S), Q4.3 (S), RGHT.2, RGHT.4, RGHT.6, RGHT.8, RGTMAX.1, RGTMIN.1, TEMPSENS.3, TMAX.1, TMIN.1, TOP.2, TOP.4, TOP.6, TOP.8
unnamed: B1.22, BMAX.2
unnamed: B1.23, TMAX.2
unnamed: B1.24, BMIN.2
unnamed: R1.2, WHITE.2
unnamed: GFP.2, R2.2
unnamed: CHERRY.2, R3.2
unnamed: B1.25, TMIN.2
unnamed: B1.2, Q1.1 (G)
unnamed: B1.4, Q2.1 (G)
unnamed: B1.6, Q3.1 (G)
unnamed: B1.27, RGTMAX.2
unnamed: B1.26, RGTMIN.2
unnamed: B1.28, LMIN.2
unnamed: B1.29, LMAX.2
unnamed: B1.44, TOP.3
unnamed: B1.45, TOP.5
unnamed: B1.42, BTM.3
unnamed: B1.43, BTM.5
unnamed: B1.46, LEFT.3
unnamed: B1.47, LEFT.5
unnamed: B1.40, RGHT.3
unnamed: B1.41, RGHT.5
unnamed: R4.2, UV.2
unnamed: B1.5V, B1.5V@1 (5V), B1.5V@2 (5V), TEMPSENS.1
unnamed: IC2.1 (A), R5.2
unnamed: B1.A1, TEMPSENS.2
unnamed: ESTOP.2, J1.1
unnamed: IC2.4 (D2), LAS1.1
unnamed: IC3.4 (D2), LAS2.1
unnamed: B1.8, R5.1
unnamed: IC4.4 (D2), LAS3.1
unnamed: IC1.3 (OUTPUT), IC2.3 (D1), IC3.3 (D1), IC4.3 (D1)
unnamed: B1.9, R6.2
unnamed: B1.10, R7.2
unnamed: Q1.2 (D), R1.1
unnamed: Q2.2 (D), R2.1
unnamed: Q3.2 (D), R3.1
unnamed: Q4.2 (D), R4.1
unnamed: B1.7, Q4.1 (G)
unnamed: IC3.1 (A), R6.1
unnamed: IC4.1 (A), R7.1
VCC: 12VFAN.1, BTM.1, CHERRY.1, ESTOP.1, GFP.1, IC1.1 (INPUT), LEFT.1, RGHT.1, TOP.1, UV.1, WHITE.1

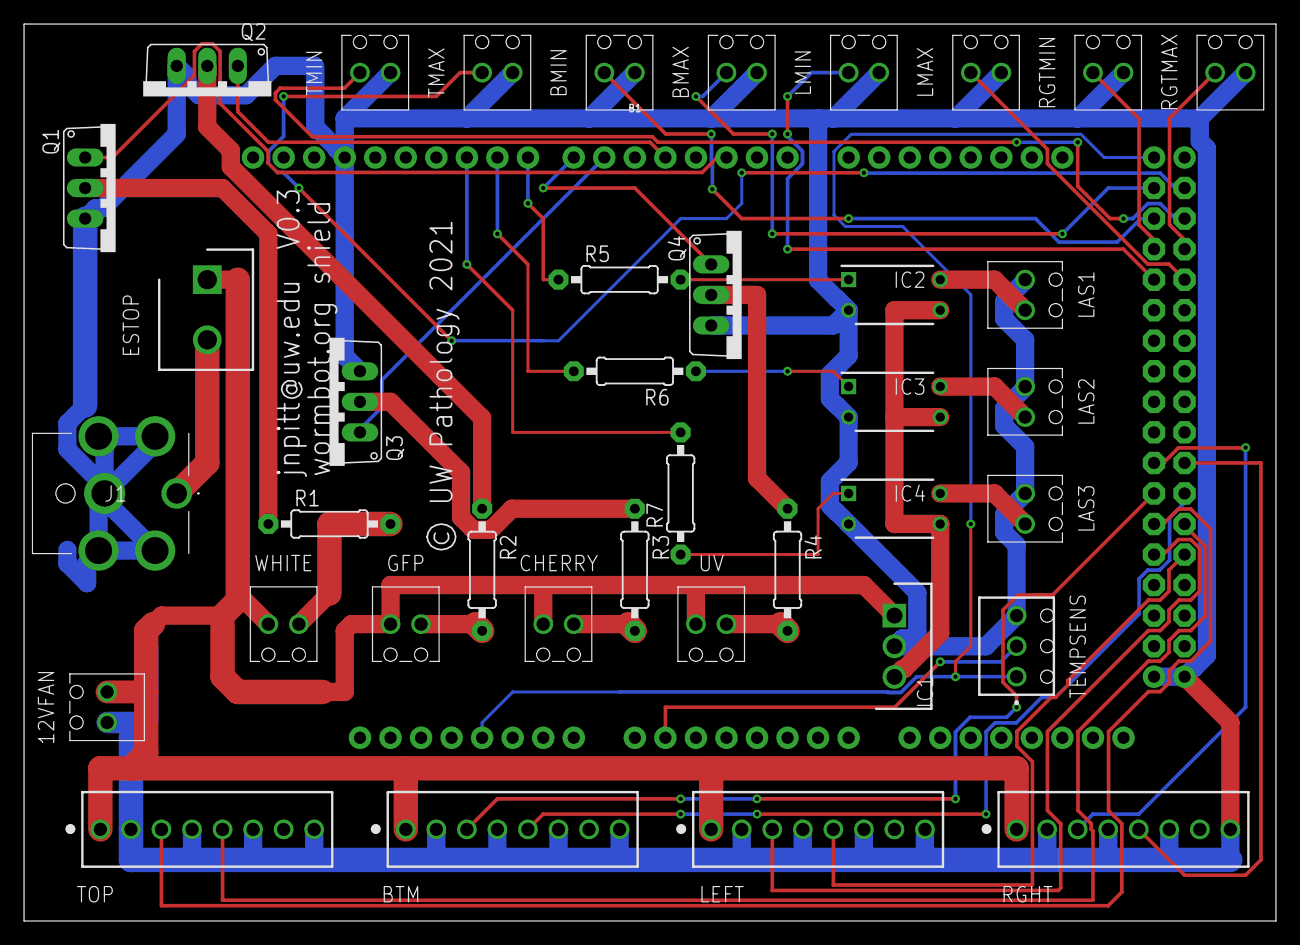
[picture p94: board 4channelWormbotShield_fixed_PCBv03_addSSRresist_wThermalRel.brd from above]

Board: 2 copper layers, 104.1 x 74.6 mm, 39 parts (0 on the bottom side), 43 nets.
