chrisburtner/rotibot/(commit log)

2020-07-09 branch from wormbotmini
    [wormbot_template.csv]
2020-08-25 forked controller to rapidscan for high frame rate timelapse
2020-09-02 updated firmware and rapidscan, NOTE motor controllers must be set to < 3 amps
2020-09-16 updated firmware, V3 now matches V1 speeds on fullsize 12plate robots, requires firmware update, NOTE ALL MOTOR CONTROLLERS SHOULD BE SET TO 3AMPS MAXIMUM
2020-11-09 added error handling for retrograde to deal with missing frames and null images
2020-11-12 increased sample number for temp sensors, added hard drive space monitoring to controller
2021-02-02 updated Temp control in firmware for 1.1V voltage internal reference
2021-07-18 fix frame increment bug
2021-12-28 pylon drivers added
2022-02-02 diffcalc and gen coords and wormlistupdater
    [q24_685.csv]
2022-02-02 update retrograde for top of frame info
2022-02-03 added eagle board files for wormbot shield
    [4channelWormbotShield_fixed_PCBv03_addSSRresist_wThermalRel.brd, 4channelWormbotShield_fixed_PCBv03_addSSRresist_wThermalRel.sch]
2022-02-23 added STL files for wormbotV3 3d printed parts
    [5wattLEDholder.stl, arduino-20mmbracket.stl, baslerUeyeCameraHolder.stl, camera20mmspacer.stl, curveWireClip.stl, fluorbase_v2.stl, highbase.stl, largeDragBracket.stl]
2022-02-25 updated bulk uploader for new exposure fluor channels
    [wormbot_template.csv]
2022-03-23 changes to bulkuploader to prevent improper templates from being uploaded, added file view to retrograde
    [wormbot_template.csv]
2022-03-30 improved retrograde blend methods, cleaned up UI, fixed frame flashing
2022-04-04 updated estop hole size and added BOM for construction
    [SEEEDstudioBOM.csv, WormbotAssemblyPartsBreakdown-byStep-mini.csv, WormbotAssemblyPartsBreakdown-totalscrews-MINI.csv, miniEStopCover-w-notch.stl, miniEStopCover.stl, v3-etop-notch-w-holes.stl, v3full_estop.stl]
2022-04-22 updated bulkuploader template to force column number to be correct on line 0
    [wormbot_template.csv]
2022-04-22 added camera type checking for UPDATE script
2022-04-22 fix cross camera build config
2022-10-05 added ordering list spreadsheets for V3 and mini
    [V3 new circuit board Wormbot Ordering List (V3 and Mini).xlsx - New Mini (1).csv, V3 new circuit board Wormbot Ordering List (V3 and Mini).xlsx - V3 (1).csv]
2022-10-07 added print set STL file for fluorescence
    for the Ender-3 Pro 3D printer
    [fluorescencePrintSet.stl]
2022-10-10 added print set STL file for v3_mini
    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
    [miniPartsPrintSet.stl]
2022-10-10 added print set STL for v3_standard
    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
    [standardPrintSet.stl]
2022-10-11 added print set STL file for common_parts
    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
    [commonPartsPrintSet_3.stl]
