chrisburtner/rotibot/(notices)

Notices in the files:
eagleFiles/4channelWormbotShield_fixed_PCBv03_addSSRresist_wThermalRel.brd:
© UW Pathology 2021
parts and their libraries:
SparkFun-Boards: Licensing: Creative Commons ShareAlike 4.0 International - https://creativecommons.org/licenses/by-sa/4.0
